nathangathright/secretlab-mac-studio-mount/mac_studio_enclosure_spec.txt

Generated by main.py. Do not edit directly.
This file is an export of the authoritative design context in main.py.

MAC STUDIO UNDER-DESK ENCLOSURE — DESIGN SPECIFICATION
======================================================

OVERVIEW
--------
A hollow, open-back enclosure sized to hold a Mac Studio on its side.
The Mac Studio slides in from the back. The enclosure mounts under a
desk via screw slots on two opposing faces.

The authoritative measurements, formulas, and design rationale live in
main.py. This text file is generated for convenient review and sharing.

REFERENCE MEASUREMENTS TO TAKE FROM YOUR MAC STUDIO
---------------------------------------------------
Measure the following from your Mac Studio with calipers:

  A.  Body width (square footprint, flat edge to flat edge)
  B.  Body height (top face to bottom face)
  C.  Body corner radius (the rounded vertical edges)
  D.  Front panel port area width
  E.  Front panel port area height
  F.  Front panel port area corner radius (if rounded)
  G.  Bottom base circle diameter (the raised or recessed ring
      on the underside — this is the ventilation intake zone)
  H.  Bottom base circle protrusion depth (how far the base
      extends below the main body, if at all)

CURRENT BUILD VALUES FROM main.py
---------------------------------
  body_w (A)                  =  197 mm
  body_h (B)                  =  95 mm
  corner_r (C)                =  30.4 mm
  base_circle_d (G)           =  179.2 mm
  base_protrusion (H)         =  8 mm
  side_clearance              =  7 mm
  tb_clearance                =  4.5 mm
  wall                        =  6 mm
  front_w_margin              =  5 mm
  front_h_margin              =  15 mm
  front_cutout_extra_w        =  12 mm
  front_cutout_cr             =  3 mm
  front_cutout_chamfer        =  1.5 mm
  rear_tip_outer_r            =  4 mm
  rear_tip_leg_angle          =  126.56 degrees
  slot_w                      =  5 mm
  slot_l                      =  10 mm
  slot_rect_w                 =  50 mm
  slot_rect_h                 =  30 mm
  slot_top_offset             =  14 mm
  slot_head_max_d             =  9.5 mm
  slot_head_clearance         =  0.5 mm
  slot_counterbore_depth      =  4 mm

MAIN BODY
---------
The enclosure is a cuboid shell that wraps the Mac Studio with a
small but intentional air gap around the body.

In the current design, the side walls grew thicker so the supplied M5
mounting hardware can sit below the interior wall surface. The outer
envelope therefore grows more than the actual body gap:

  Enclosure width  =  A + 14 mm
  Enclosure depth  =  A + 14 mm  (same, since the footprint is square)
  Enclosure height =  B + 9 mm

With the current build values in main.py:

  Enclosure width  =  211 mm
  Enclosure depth  =  211 mm
  Enclosure height =  104 mm

The current side-wall gap resolves to about
1 mm per side on the screw-wall axis.

All four long edges of the cuboid are rounded. The enclosure corner
radius should match the Mac Studio's own corner profile plus the
same clearance:

  Enclosure corner radius  =  C + side_clearance
  Inner corner radius      =  enclosure corner radius - wall

With the current build values:

  Enclosure corner radius  =  37.4 mm
  Inner corner radius      =  31.4 mm

The enclosure is hollow with a uniform wall thickness of
6 mm. This is a structural choice rather than a
measured Mac Studio dimension. The extra thickness leaves enough material
behind the interior screw-head recesses while keeping the shell rigid
without relying on infill.

FACE DEFINITIONS
----------------
Orient the model so the front face (where the Mac Studio's front
ports are) faces you:

  Front:   Width x Height  (display/port cutout)
  Back:    Width x Height  (entirely open)
  Left:    Depth x Height  (screw slots)
  Right:   Depth x Height  (screw slots)
  Top:     Width x Depth   (square cutout)
  Bottom:  Width x Depth   (circular cutout and channel)

BACK — OPEN
-----------
The entire back face is removed. The Mac Studio slides in from this
side, and all rear ports and the power cable remain accessible.

FRONT — PORT/DISPLAY CUTOUT
---------------------------
A rectangular cutout on the front face, centered both horizontally
and vertically, passing fully through the 6 mm wall.

The implemented opening keeps the cutout centered, increases its width,
reduces its corner radius, and adds a light chamfer on the exterior
edge of the wall:

  Cutout width   =  enclosure width
                   - 2 x enclosure corner radius
                   - 2 x front-width margin
                   + 12 mm extra width

  Cutout height  =  enclosure height - 2 x front-height margin

With the current build values:

  Cutout width   =  138.2 mm
  Cutout height  =  74 mm

All four corners of this cutout are rounded with a small radius:

  Cutout corner radius  =  3 mm

The outer edge of the front wall is chamfered around the opening:

  Front cutout chamfer  =  1.5 mm

TOP — SQUARE CUTOUT
-------------------
A square cutout centered on the top face, passing fully through the
6 mm wall. This saves material and can aid ventilation.

The current design ties the top opening directly to the front opening
width for visual consistency:

  Top cutout side       =  front cutout width
  Top cutout corner r   =  front cutout corner r
  Top cutout chamfer    =  front cutout chamfer

With the current build values:

  Top cutout side       =  138.2 mm
  Top cutout corner r   =  3 mm
  Top cutout chamfer    =  1.5 mm

That still leaves roughly 36.4 mm of material
between the opening and the outer edge on each flat side of the
211 mm top face.

BOTTOM — CIRCULAR CUTOUT AND CHANNEL
------------------------------------
A circular cutout centered on the bottom face, passing fully through
the 6 mm wall. This aligns with and exposes the
Mac Studio's bottom ventilation intake.

  Circle diameter  =  G  (the diameter of the base ring/vent circle
    on the Mac Studio's underside)

With the current build values:

  Circle diameter  =  179.2 mm

The current model also keeps a rear channel from the widest point of the
circle to the back edge so the base can slide in from the rear:

  Channel width   =  G
  Channel length  =  half the enclosure depth

With the current build values:

  Channel width   =  179.2 mm
  Channel length  =  105.5 mm

The rear tips of the outer baseplate profile are softened for handling
comfort, but that relief does not change the actual circle-plus-channel
bottom opening.

LEFT AND RIGHT SIDES — SCREW SLOTS
----------------------------------
Each side face has four slotted holes for mounting hardware. The
pattern is identical on both sides.

Slot dimensions:
  Each slot is a stadium (oblong) shape, 10 mm long and
  5 mm wide. The 5 mm width provides
  clearance for M5 bolts. The 10 mm length provides
  adjustment travel for alignment during installation.

  On the interior face, each slot also gets a matching oblong
  counterbore pocket:

    Counterbore width   =  10 mm
    Counterbore length  =  15 mm
    Counterbore depth   =  4 mm

  This pocket is sized around a 9.5 mm maximum
  screw-head diameter and keeps either of the supplied M5 x 10 mm
  Secretlab screw styles below flush with the interior wall surface.

Slot arrangement:
  The four slots form a rectangle on each side face:

    Rectangle width   =  50 mm  (along the depth axis)
    Rectangle height  =  30 mm  (along the height axis)

  The rectangle is centered along the depth of the face. The top
  edge is 14 mm from the top of the enclosure.

  Slot center positions (measured from the top-front corner of the
  side face):

    Top-front:      80.5 mm from front,  14 mm from top
    Top-back:       130.5 mm from front,  14 mm from top
    Bottom-front:   80.5 mm from front,  44 mm from top
    Bottom-back:    130.5 mm from front,  44 mm from top

Slot orientation:
  Each slot's long axis is angled to point toward the center of the
  50 x 30 mm rectangle. Tightening the bolts tends to pull the
  enclosure toward a centered position on the mounting bracket.

  Current slot angle from vertical  =  approximately 59 degrees

MOUNTING ORIENTATION
--------------------
In use, the enclosure hangs under a desk. One screw-slot face is
fastened against the underside of the desk (or a mounting bracket
attached to the desk). The opposite screw-slot face faces the floor.

The Mac Studio sits on its side inside the enclosure. The open back
faces outward for cable access, and the front cutout keeps the front
ports and power indicator accessible.
