nathangathright/secretlab-mac-studio-mount/PRINTING.md

<!-- Generated by main.py. Do not edit directly. -->

# 3D Printing Instructions - Mac Studio Under-Desk Enclosure

## Print Orientation

Print upside-down with the top face (square cutout) on the build plate and the bottom face (circular vent cutout / vent-ring face) facing up.

```
        ┌── bottom face (circle+channel) ─┐
        │                                  │
        │         ▲ build direction        │
        │         │  (104 mm)              │
        │   rounded corners run            │
        │   vertically along build axis    │
        │         │                        │
        ├─────────┴────────────────────────┤
        │   top face on bed (square cutout)│
        └──────────────────────────────────┘
              211 mm × 211 mm footprint
              104 mm tall print
```

- **Best corner finish.** The four rounded edges run along the build axis. Each layer traces a smooth arc with no stairstepping on the main vertical corners.
- **Strong bed adhesion.** The top face has a roughly 138.2 mm square cutout, leaving about a 36.4 mm-wide frame of contact area and roughly 25422 mm² of total bed contact.
- **Smooth finish where it counts.** The top face, which is most visible when mounted, gets the smooth bed-contact surface.
- **Still compact for the added hardware margin.** Only 104 mm tall.
- **Usually no supports needed.** In the recommended orientation, the vent circle and rear channel open upward, so most slicers can print the shell cleanly without support material. If your slicer preview shows sagging bridges for your machine or material, add supports only where needed.
- **Strong layer orientation.** Mounting screw loads go through the side walls in shear, not in layer-separating tension.
- **Requires a 220+ mm bed** in both X and Y.

## Material

**PETG — recommended.** Best overall balance of strength, heat tolerance, and printability.

| Material | Heat Deflection | Strength | Printability | Verdict |
|---|---|---|---|---|
| **PETG** | ~80 °C | Good | Easy | **Recommended** |
| ASA | ~100 °C | Very good | Moderate (needs enclosure, ventilation) | Best if you have an enclosed printer |
| ABS | ~100 °C | Good | Difficult (warps badly at a 211 mm footprint) | Not recommended at this size |
| PLA | ~55 °C | Adequate | Easiest | **Do not use** — Mac Studio exhaust heat will soften it over time |
| PA/Nylon | ~180 °C | Excellent | Difficult (moisture-sensitive) | Overkill, but works if you have the setup |

**Why not PLA?** The Mac Studio's exhaust can sustain 50-60 °C at the vent surface. PLA's heat deflection temperature is around 55 °C. Under sustained load, the enclosure will creep and deform. PETG's higher heat tolerance provides a much better margin.

**Why not ABS?** ABS has excellent heat resistance but shrinks significantly as it cools. On a 211 mm footprint, warping is very likely unless you have an actively heated chamber. ASA is a better alternative with similar thermal properties and less warping.

## Print Settings

| Setting | Value | Rationale |
|---|---|---|
| Layer height | 0.2 mm | Good balance of speed and surface quality |
| Nozzle | 0.4 mm | Standard; 0.6 mm also works and cuts print time significantly |
| Wall count / perimeters | 13-14 | Fills the 6 mm wall almost entirely with perimeters. At 0.45 mm line width, 13 perimeters ≈ 5.85 mm and 14 perimeters ≈ 6.3 mm. |
| Top / bottom solid layers | 10-12 | Keeps the smaller horizontal bridges and edge transitions well supported |
| Infill | 0% | Not needed — the shell is driven by thick walls and perimeter structure |
| Bed adhesion | Brim, 5-8 mm | Helps resist corner lift on a 211 mm footprint |
| Supports | Off by default | Usually not needed in the recommended orientation; check your slicer preview before enabling them |
| Print speed | 40-60 mm/s (PETG) | Conservative speed for good layer adhesion. Outer walls at 30-40 mm/s for surface finish. |
| Nozzle temp | 230-245 °C (PETG) | Check your filament's datasheet. Higher values usually improve layer bonding. |
| Bed temp | 70-80 °C (PETG) | Standard for PETG adhesion |
| Cooling fan | 30-50% (PETG) | Too much cooling weakens layer adhesion; too little causes stringing |

## Post-Processing

1. **Remove the brim** with a deburring tool or flush cutters.
2. **Lightly sand the front face** (the bed-contact surface) with 220-grit sandpaper to smooth any elephant's foot or brim remnants.
3. **Test-fit the Mac Studio** before mounting. The current slot-wall gap is intentionally tight, so expect about 1 mm of nominal clearance per side on that axis. The rear bottom tips are softened on the outer baseplate profile for handling comfort, but the vent circle and rear channel opening are unchanged from the original fit geometry.
4. **Add felt pads if needed** to eliminate play. Thin adhesive felt, about 0.5-1.0 mm thick, works well. Use a few small pads instead of long strips. Keep pads clear of the bottom vent opening, the rear slide-in path, and the front opening edges.
5. **Check screw slot alignment** by holding the enclosure against your mounting bracket and passing M5 bolts through the slots. The 10 mm slot length provides adjustment travel, and the interior counterbores should leave both the button-head and pan-head screw options below flush.

## Pre-Print Checklist

- [ ] Printer Z height ≥ 110 mm
- [ ] Bed size ≥ 220 × 220 mm
- [ ] PETG filament (or ASA if you have an enclosed printer)
- [ ] Bed cleaned and leveled
- [ ] Brim enabled
- [ ] Supports off by default; enable only if your slicer preview shows a problem area
- [ ] Wall count set to 13-14 perimeters to fill the 6 mm wall
