nathangathright/secretlab-mac-studio-mount/(commit log)

2026-02-20 Initial commit: Mac Studio under-desk mount for Secretlab Magnus Pro
    Parametric OpenSCAD enclosure that lets you mount a Mac Studio under a
    Secretlab Magnus Pro desk using its built-in screw holes. Includes the
    design source, pre-built STL, printing instructions, design spec, and
    a Blender turnaround render script.
    [mac_studio_enclosure.scad]
2026-04-13 Align model orientation and add turnaround preview mode
    [mac_studio_enclosure.scad]
2026-04-13 Refine rear tip relief geometry
    [mac_studio_enclosure.scad]
2026-04-13 Document rear tip relief and still-frame preview rendering
2026-04-14 Refine enclosure openings and streamline turnaround renders
    [mac_studio_enclosure.scad]
2026-04-15 Add main.py build pipeline and glass USDZ export
    [mac_studio_enclosure.scad]
2026-04-15 Refactor turnaround placement and camera orbit
